technoblogy/mega-tiny-time-watch/README.md

# Mega Tiny Time Watch
A watch based on an ATtiny414, showing the time analogue-style on 12 LEDs.
For more information see: http://www.technoblogy.com/show?2OKF.
