technoblogy/mega-tiny-time-watch/Eagle files/MegaTinyTimeWatch.brd

## EAGLE design Eagle files/MegaTinyTimeWatch.brd (2020-01-07)

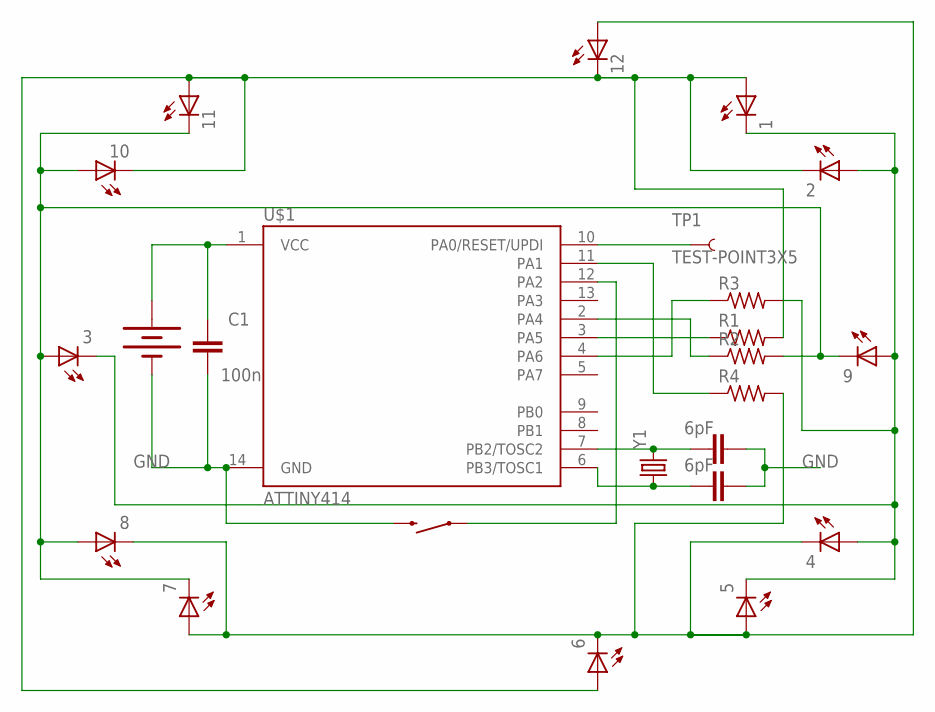
[picture p1: schematic MegaTinyTimeWatch.sch]

Parts:
1, 2, 3, 4, 5, 6, 7, 8, 9, 10, 11, 12: LEDCHIPLED_0805; CHIPLED_0805
BAT1: 20mm coincell; BATTCON_20MM_4LEGS
C1: 100n; 0603-CAP
C2, C12: 6pF; 0603-CAP
R1, R2, R3, R4: R-US_M0805; M0805
S2: SWITCH-MOMENTARY-2SMD; TACTILE-SWITCH-SMD
TP1: TEST-POINT3X5; PAD.03X.05
U$1: ATTINY414; SO14
Y1: CRYSTAL32-SMD-MELF; CRYSTAL-32KHZ-SMD-MELF

Connections:
GND: BAT1.NEGATIVE (-), C1.2, C2.1, C12.1, S2.3 (2), U$1.14 (GND)
unnamed: 1.C, 2.A, 3.C, 4.A, 5.C, 9.A, R3.2
unnamed: 4.C, 5.A, 6.C, 7.A, 8.C, 12.A, R4.2
unnamed: 3.A, 7.C, 8.A, 9.C, 10.A, 11.C, R2.2
unnamed: 1.A, 2.C, 6.A, 10.C, 11.A, 12.C, R1.2
unnamed: R3.1, U$1.4 (PA6)
unnamed: S2.1, U$1.12 (PA2)
unnamed: R2.1, U$1.2 (PA4)
unnamed: R4.1, U$1.11 (PA1)
unnamed: BAT1.POSITIVE@1 (+), BAT1.POSITIVE@2 (+), BAT1.POSITIVE@3 (+), BAT1.POSITIVE@4 (+), C1.1, U$1.1 (VCC)
unnamed: TP1.P$1, U$1.10 (PA0/RESET/UPDI)
unnamed: C12.2, U$1.7 (PB2/TOSC2), Y1.X2 (2)
unnamed: R1.1, U$1.3 (PA5)
unnamed: C2.2, U$1.6 (PB3/TOSC1), Y1.X1 (1)

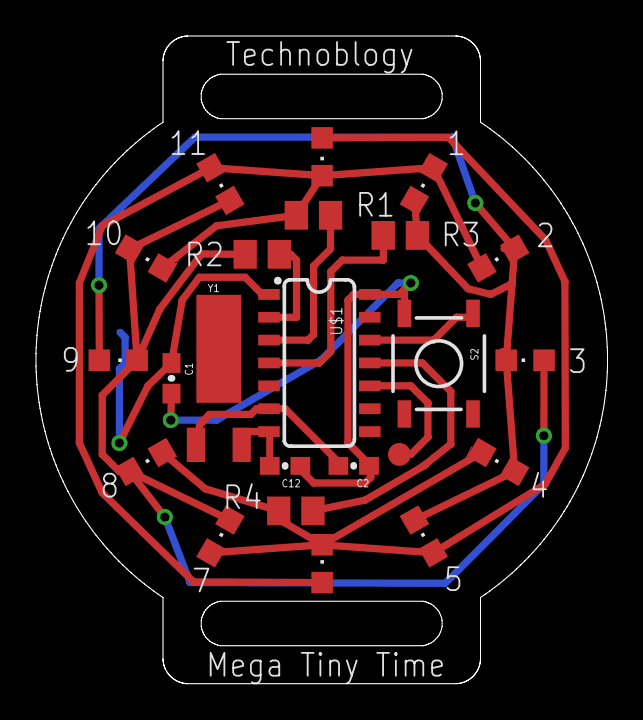
[picture p2: board MegaTinyTimeWatch.brd from above]

Board: 2 copper layers, 31.7 x 36.0 mm, 24 parts (1 on the bottom side), 14 nets.
