technoblogy/mega-tiny-time-watch/(commit log)

2020-01-07 Version 1 - 7th January 2020
    [MegaTinyTimeWatch.brd, MegaTinyTimeWatch.sch]
2021-03-04 Version 2 - 8th November 2020
    Fixes problems - see original article
    [MegaTinyTimeWatch.ino]
